kokospalme/KiCad_Firepot/BOM/V1.0_LCSC_Exported_20200425_042555.xlsx

LCSC Part Number | Manufacture Part Number | Manufacturer | Package | Customer # | Description | RoHS | Order Qty. | Min\Mult Order Qty. | Unit Price | Order Price | Product Link | qty | price
C376006 | DS18B20 | UMW(Youtai Semiconductor Co., Ltd.) | TO-92 | U4 | TO-92 Temperature Sensors RoHS | yes | 1 | 1 | 0.784318 | 0.78 | lcsc.com/product-detail/Temperature-Sensors_UMW-Youtai-Semiconductor-Co-Ltd-DS18B20_C376006.html | 1 | 0.7800 €
C39051 | MCP1700T-3302E/TT | Microchip Tech | SOT-23(SOT-23-3) | U2 | Fixed 6V 3.3V 250mA SOT-23(SOT-23-3) Low Dropout Regulators(LDO) RoHS | yes | 1 | 1 | 0.294207 | 0.29 | lcsc.com/product-detail/Low-Dropout-Regulators-LDO_Microchip-Tech-MCP1700T-3302E-TT_C39051.html | 1 | 0.2900 €
C82894 | ESP-07 | Ai-Thinker | Module | U1 | Module WIFI Modules RoHS | yes | 1 | 1 | 2.238409 | 2.24 | lcsc.com/product-detail/WIFI-Modules_Ai-Thinker-ESP-07_C82894.html | 1 | 2.2400 €
C231731 | KAN0441C-0252B1 | GANGYUAN | SMD | SW_PSH | SPST-NO 50mA @ 12VDC Top Actuated Rectangular Button SMD Tactile Switches RoHS | yes | 10 | 10 | 0.058407 | 0.58 | lcsc.com/product-detail/Tactile-Switches_GANGYUAN-KAN0441C-0252B1_C231731.html | 2 | 0.1160 €
C388633 | SS-12D11G5R | XKB Enterprise | Through Hole | SW2 | SPDT 5A 120V On-On Through Hole Toggle Switches RoHS | yes | 1 | 1 | 0.31107 | 0.31 | lcsc.com/product-detail/Toggle-Switches_XKB-Enterprise-SS-12D11G5R_C388633.html | 1 | 0.3100 €
C380783 | SY1206JN10KP | SANYEAR | 1206 | R | 10K ±5% 1/8W ±100ppm/°C 1206 Chip Resistor - Surface Mount RoHS | yes | 100 | 100 | 0.003051 | 0.31 | lcsc.com/product-detail/Chip-Resistor-Surface-Mount_SANYEAR-SY1206JN10KP_C380783.html | 10 | 0.0310 €
C357397 | PM3X4 | Shuntian | 3X4mm | SCR2 | 3X4mm Screw RoHS | yes | 100 | 100 | 0.002488 | 0.25 | lcsc.com/product-detail/Screw_Shuntian-PM3X4_C357397.html | 1 | 0.0025 €
C118179 | C118179 | HIWA | M3*5+6 | SCR1 | M3*5+6 Studs RoHS | yes | 20 | 20 | 0.022096 | 0.44 | lcsc.com/product-detail/Studs_HIWA-C118179_C118179.html | 1 | 0.0220 €
C102228 | CR1206F46042G | LIZ Elec | 1206 | R2 | 60.4K ±1% 1/4W ±100ppm/°C 1206 Chip Resistor - Surface Mount RoHS | yes | 100 | 100 | 0.002853 | 0.29 | lcsc.com/product-detail/Chip-Resistor-Surface-Mount_LIZ-Elec-CR1206F46042G_C102228.html | 1 | 0.0029 €
C102311 | CR1206J40224G | LIZ Elec | 1206 | R1 | 220K ±5% 1/4W ±200ppm/°C 1206 Chip Resistor - Surface Mount RoHS | yes | 100 | 100 | 0.003167 | 0.32 | lcsc.com/product-detail/Chip-Resistor-Surface-Mount_LIZ-Elec-CR1206J40224G_C102311.html | 1 | 0.0032 €
C131339 | B3B-PH-K-S(LF)(SN) | JST Sales America | Through Hole | J2 | PH Header Male Pin 0.079"(2.00mm) 3 Through Hole Wire To Board / Wire To Wire Connector RoHS | yes | 10 | 10 | 0.033022 | 0.33 | lcsc.com/product-detail/Wire-To-Board-Wire-To-Wire-Connector_JST-Sales-America-B3B-PH-K-S-LF-SN_C131339.html | 1 | 0.0330 €
C283540 | TYPE-C-31-M-17 | Korean Hroparts Elec | - | J1 | USB - Type C Female 6 USB Connectors RoHS | yes | 1 | 1 | 0.21902 | 0.22 | lcsc.com/product-detail/USB-Connectors_Korean-Hroparts-Elec-TYPE-C-31-M-17_C283540.html | 1 | 0.2200 €
C114586 | WS2812B-B | Worldsemi | SMD,5x5mm | D1 | RGB 620~630nmRed,515~530nmGreen,465~475nmBlue SMD,5x5mm Light Emitting Diodes (LED) RoHS | yes | 5 | 5 | 0.099749 | 0.5 | lcsc.com/product-detail/Light-Emitting-Diodes-LED_Worldsemi-WS2812B-B_C114586.html | 1 | 0.1000 €
C360619 | TCC0805X7R104M500DT | CCTC | 0805 | C1 | 100nF ±20% 50V X7R 0805 Multilayer Ceramic Capacitors MLCC - SMD/SMT RoHS | yes | 50 | 50 | 0.00792 | 0.4 | lcsc.com/product-detail/Multilayer-Ceramic-Capacitors-MLCC-SMD-SMT_CCTC-TCC0805X7R104M500DT_C360619.html | 1 | 0.0080 €
 |  |  |  |  |  |  |  |  |  |  |  | Bauteile | 4.16 €
 |  |  |  |  |  |  |  |  |  |  |  | PCB | 0.56 €
 |  |  |  |  |  |  |  |  |  |  |  | LED | 8.25 €
 |  |  |  |  |  |  |  |  |  |  |  | Batterie | 2.55 €
 |  |  |  |  |  |  |  |  |  |  |  | Rohr | 0.24 €
 |  |  |  |  |  |  |  |  |  |  |  | Blende | 0.50 €
 |  |  |  |  |  |  |  |  |  |  |  | Summe | 16.26 €
