kokospalme/KiCad_Firepot/CAD/Assembly.FCStd

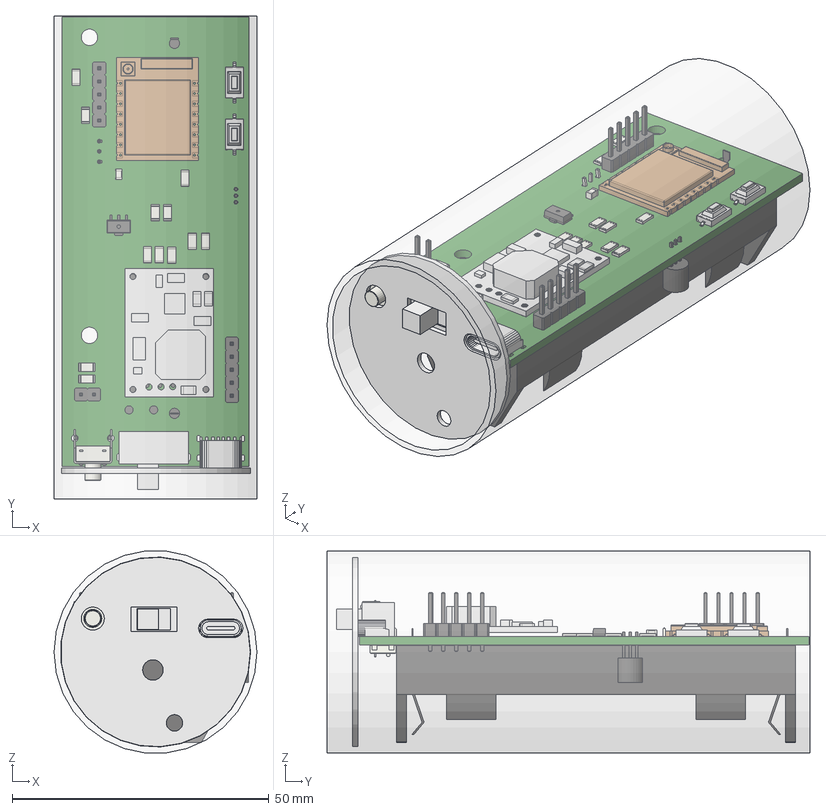
[picture p1: CAD file, 2020-05-01]
CAD/Assembly.FCStd
39.5 x 94.0 x 39.3 mm
Rohr
Blende
