kokospalme/KiCad_Firepot/CAD/PCB1.FCStd

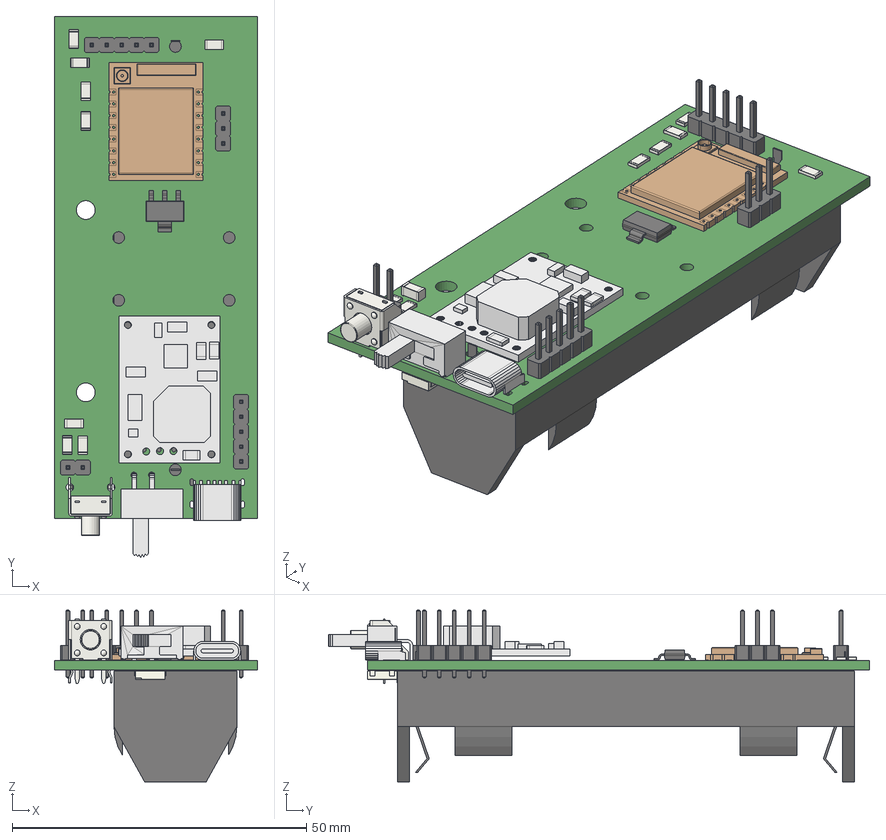
[picture p2: CAD file, 2020-05-01]
CAD/PCB1.FCStd
34.5 x 92.0 x 29.2 mm
