kokospalme/KiCad_Firepot/CAD/Blende_v1_0.step

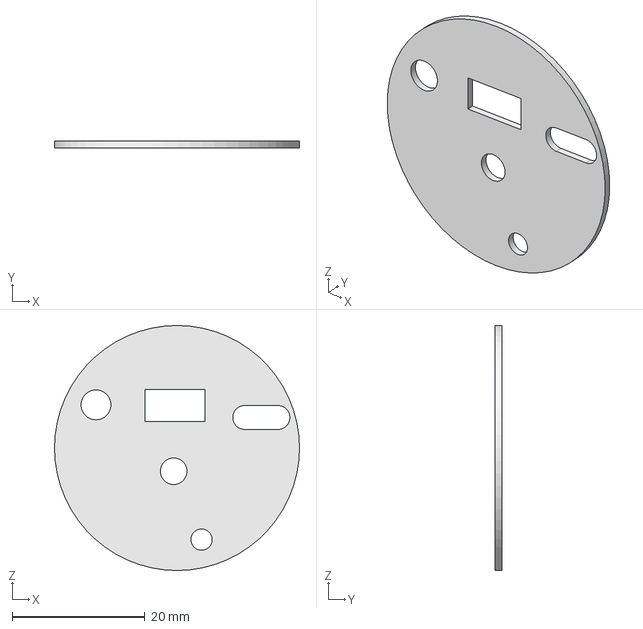
[picture p3: CAD file, 2020-05-01]
CAD/Blende_v1_0.step
36.9 x 1.00 x 36.9 mm
