kokospalme/KiCad_Firepot/(list of files, cad)

Other CAD files:
CAD/BlendeV1_0.dxf
CAD/Blende_v1_0.FCStd
