kokospalme/KiCad_Firepot/CAD/BlendeV1_0.pdf

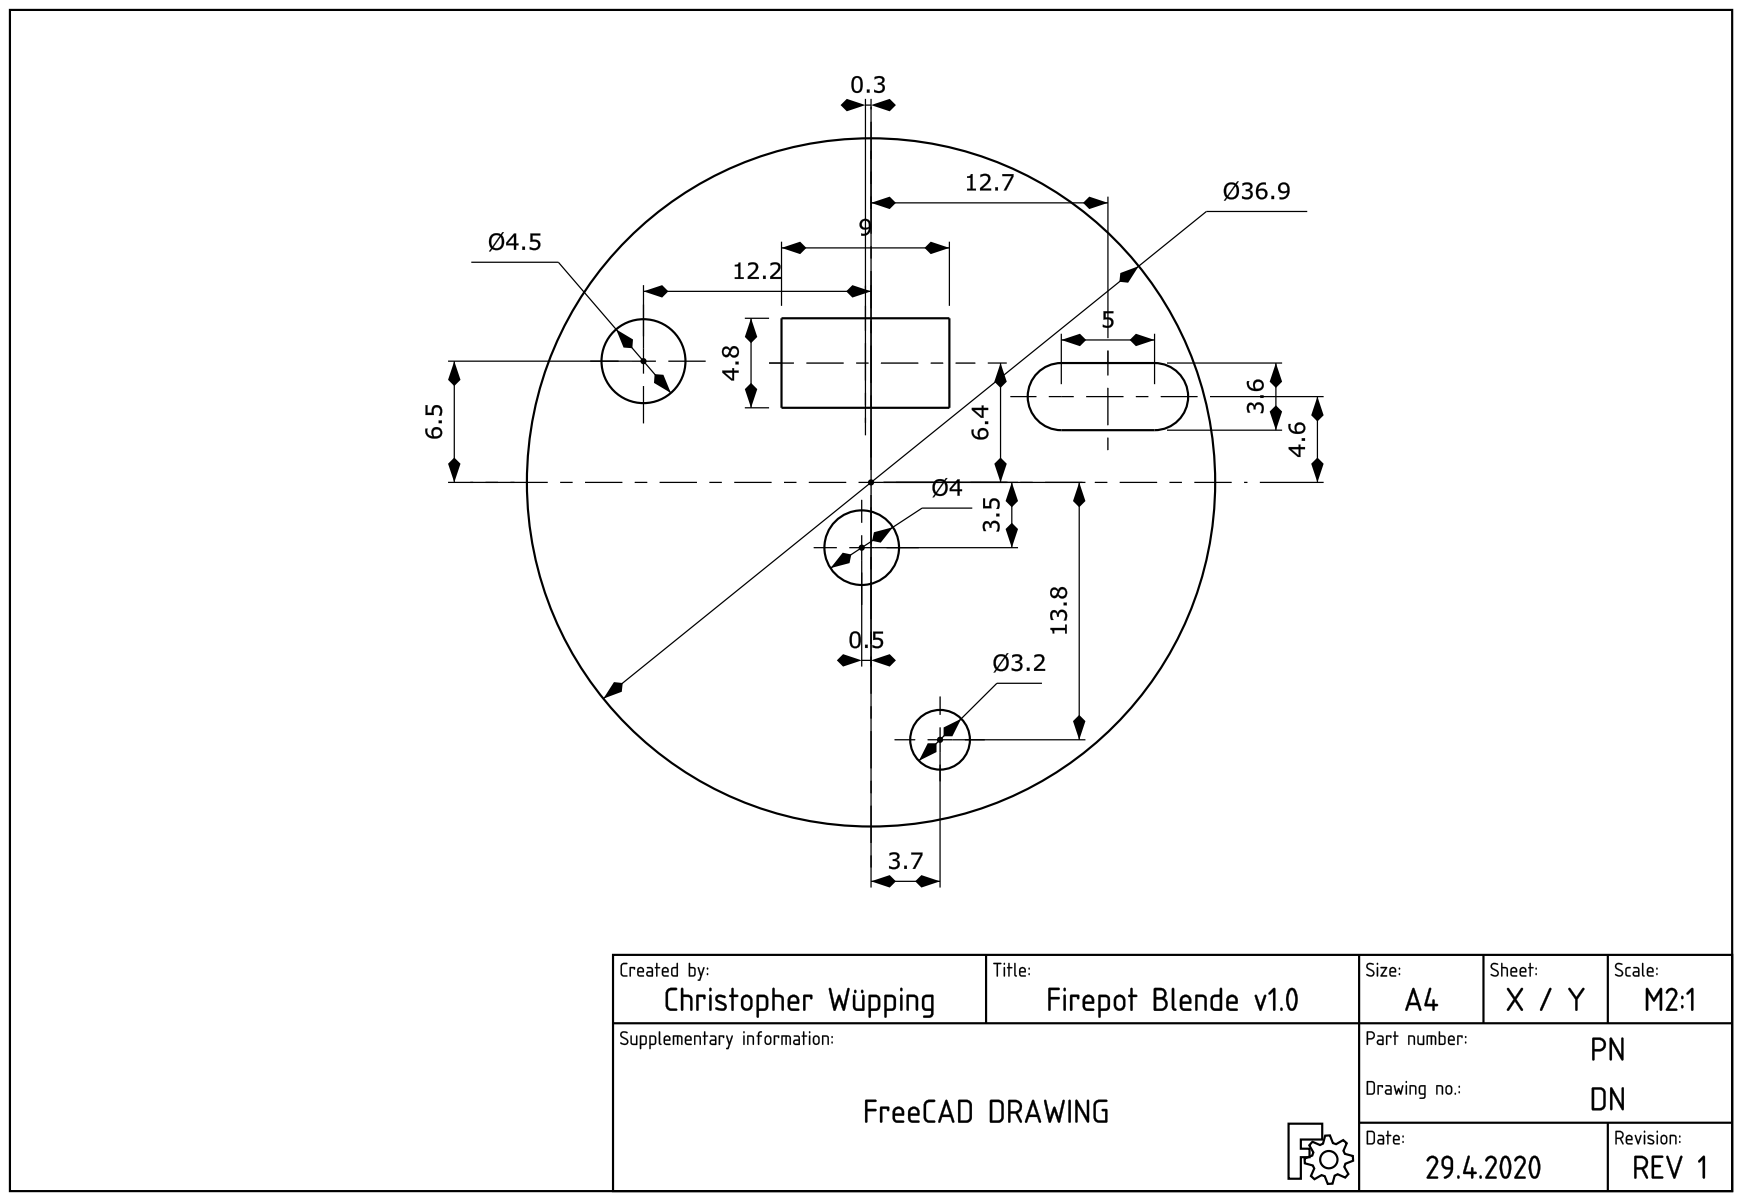
[picture p4: page 1]
