kokospalme/KiCad_Firepot/Firepot.kicad_pcb

## KiCad design Firepot.kicad_pcb (2020-05-01)

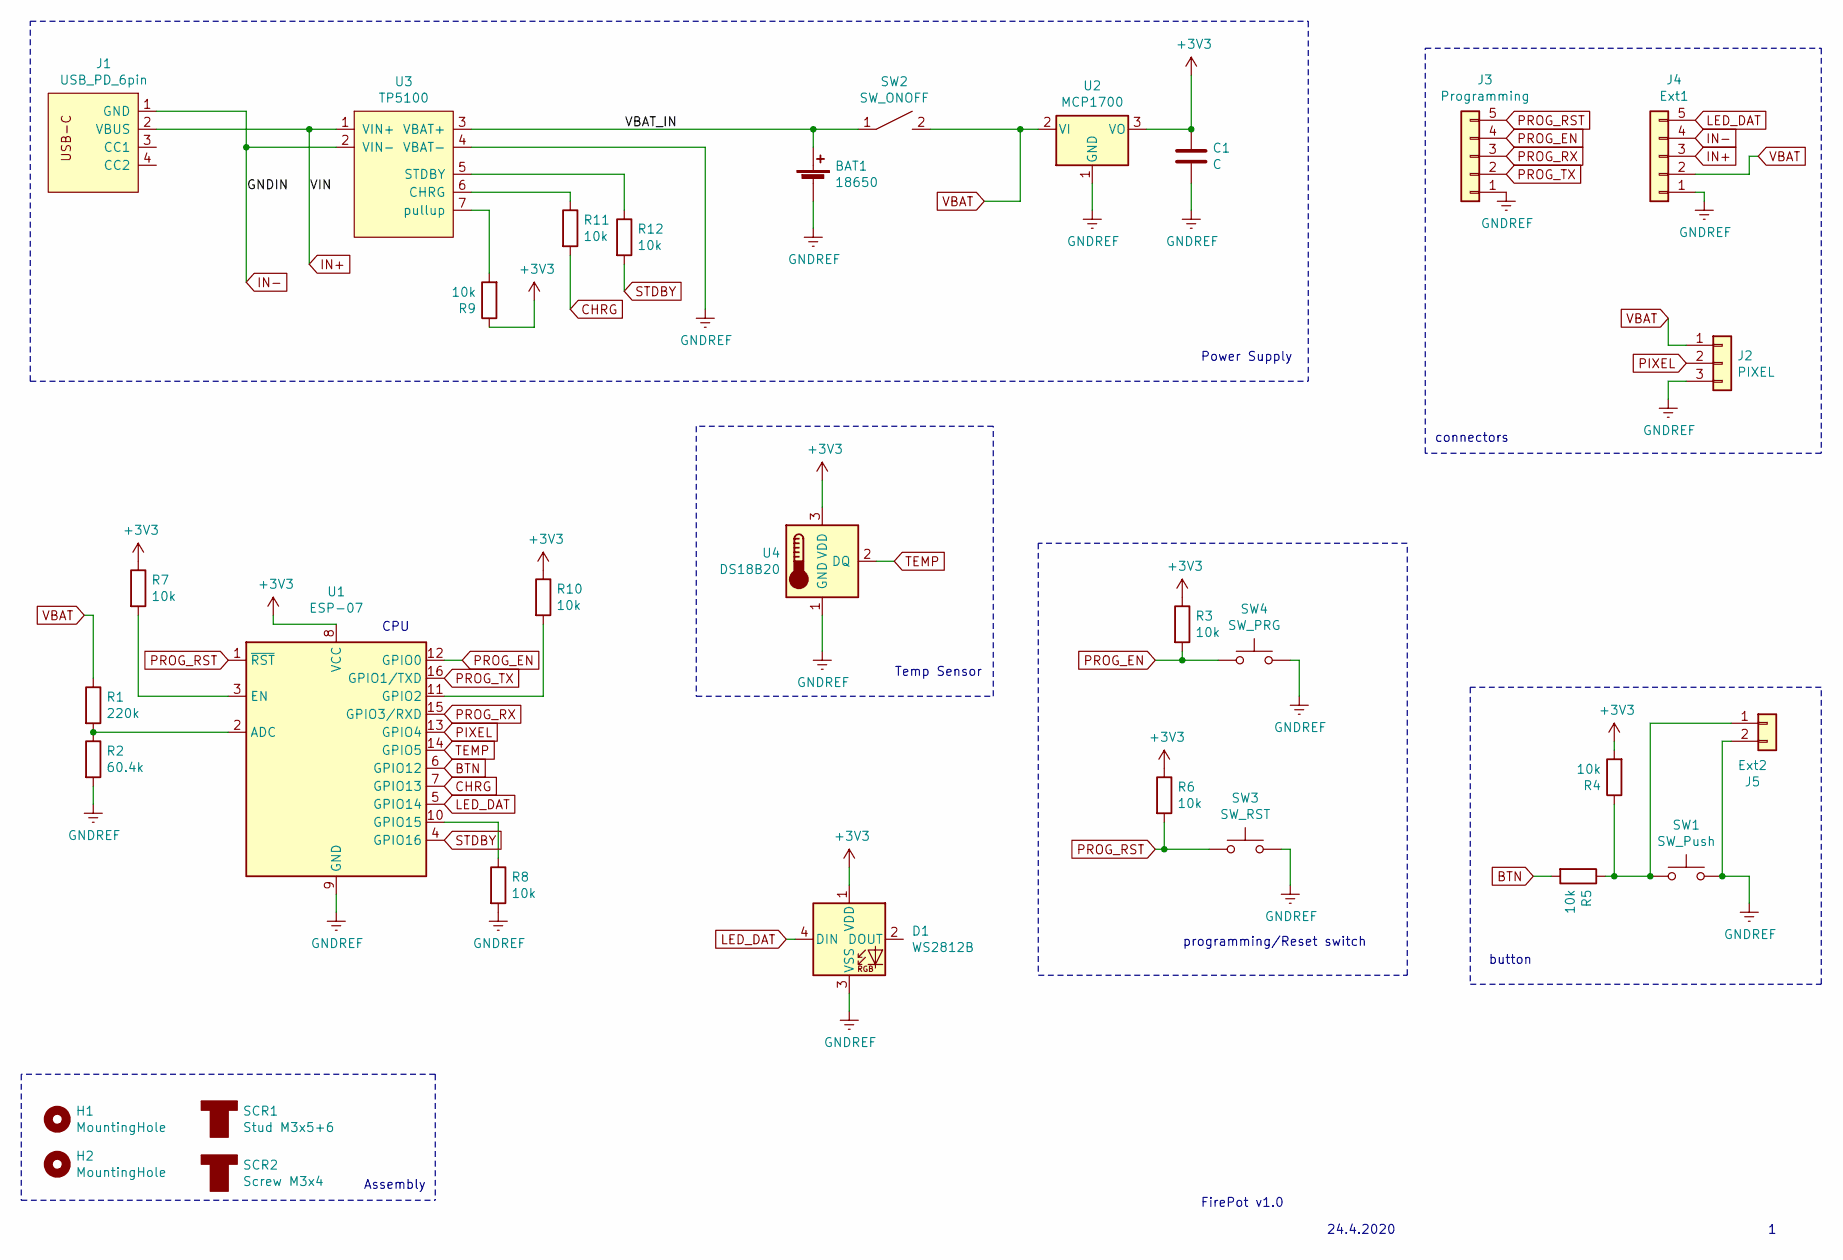
[picture p5: schematic Firepot.sch]

Parts:
BAT1: 18650; BatteryHolder_MPD_BH-18650-PC2
C1: C; C_0805_2012Metric; LCSC C360619
D1: WS2812B; LED_WS2812B_PLCC4_5.0x5.0mm_P3.2mm; LCSC C114586
H1, H2: MountingHole; MountingHole_3.2mm_M3
J1: USB_PD_6pin; LCSC C283540
J2: PIXEL; JST_PH_B3B-PH-K_1x03_P2.00mm_Vertical; LCSC C131339
J3: Programming; PinHeader_1x05_P2.54mm_Vertical
J4: Ext1; PinHeader_1x05_P2.54mm_Vertical
J5: Ext2; PinHeader_1x02_P2.54mm_Vertical
R1: 220k; R_1206_3216Metric_Pad1.42x1.75mm_HandSolder; LCSC C102311
R2: 60.4k; R_1206_3216Metric_Pad1.42x1.75mm_HandSolder; LCSC C102228
R3, R4, R5, R6, R7, R8, R9, R10, R11, R12: 10k; R_1206_3216Metric_Pad1.42x1.75mm_HandSolder; LCSC C380783
SCR1: Stud M3x5+6; LCSC C118179
SCR2: Screw M3x4; LCSC C357397
SW1: SW_Push; SW_Tactile_SPST_Angled_PTS645Vx58-2LFS
SW2: SW_ONOFF; SS-12D11G5R_2pin; LCSC C388633
SW3: SW_RST; SW_SPST_CK_RS282G05A3; LCSC C231731
SW4: SW_PRG; SW_SPST_CK_RS282G05A3; LCSC C231731
U1: ESP-07; LCSC C82894
U2: MCP1700; SOT-23; LCSC C39051
U3: TP5100
U4: DS18B20; TO-92_Inline; LCSC C376006

Connections:
+3V3: C1.1, D1.1 (VDD), R3.1, R4.2, R6.1, R7.1, R9.1, R10.1, U1.8 (VCC), U2.3 (VO), U4.3 (VDD)
/VBAT_IN: BAT1.1 (+), SW2.1, U3.3 (VBAT+)
BTN: R5.2, U1.6 (GPIO12)
CHRG: R11.2, U1.7 (GPIO13)
GNDREF: BAT1.2 (-), C1.2, D1.3 (VSS), J2.3, J3.1, J4.1, J5.2, R2.2, R8.2, SW1.2, SW3.2, SW4.2, U1.9 (GND), U2.1 (GND), U3.4 (VBAT-), U4.1 (GND)
IN+: J1.2 (VBUS), J4.3, U3.1 (VIN+)
IN-: J1.1 (GND), J4.4, U3.2 (VIN-)
LED_DAT: D1.4 (DIN), J4.5, U1.5 (GPIO14)
unnamed: J5.1, R4.1, R5.1, SW1.1
unnamed: R1.2, R2.1, U1.2 (ADC)
unnamed: R7.2, U1.3 (EN)
unnamed: R8.1, U1.10 (GPIO15)
unnamed: R9.2, U3.7 (pullup)
unnamed: R10.2, U1.11 (GPIO2)
unnamed: R11.1, U3.6 (CHRG)
unnamed: R12.1, U3.5 (STDBY)
PIXEL: J2.2, U1.13 (GPIO4)
PROG_EN: J3.4, R3.2, SW4.1, U1.12 (GPIO0)
PROG_RST: J3.5, R6.2, SW3.1, U1.1 (~RST)
PROG_RX: J3.3, U1.15 (GPIO3/RXD)
PROG_TX: J3.2, U1.16 (GPIO1/TXD)
STDBY: R12.2, U1.4 (GPIO16)
TEMP: U1.14 (GPIO5), U4.2 (DQ)
VBAT: J2.1, J4.2, R1.1, SW2.2, U2.2 (VI)

Notes on the sheet:
connectors
button
Power Supply
programming/Reset switch
Temp Sensor
FirePot v1.0
24.4.2020
Assembly
CPU

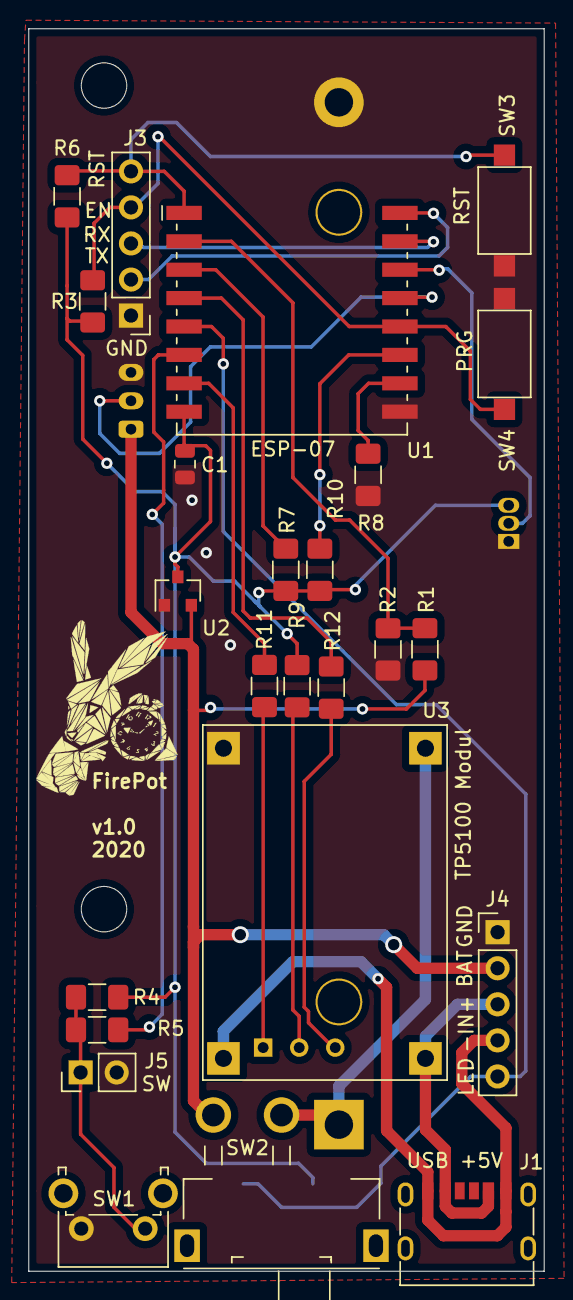
[picture p6: board Firepot.kicad_pcb from above]

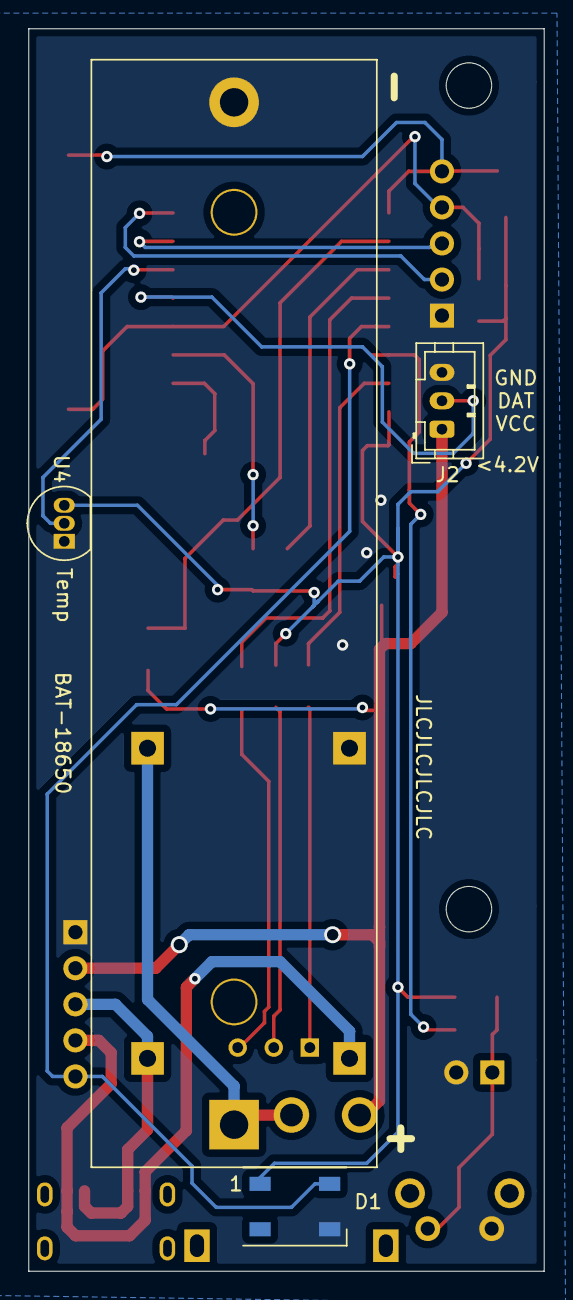
[picture p7: board Firepot.kicad_pcb from below]

Board: 2 copper layers, 36.3 x 87.5 mm, 30 parts (4 on the bottom side), 24 nets.
